priyanshu0915/AC-DC-CONVERTER-FOR-SPEED-CONTROL-OF-A-DC-MOTOR-/README.md

# AC-DC CONVERTER FOR SPEED CONTROL OF A DC MOTOR
<p>This project involves designing and implementing a two-stage AC-DC converter specifically tailored to control the speed of a DC motor. The converter utilizes advanced power electronics to provide efficient and stable speed control, making it suitable for various applications requiring precise motor regulation.</p>
<br>
References 
<br>
1. Anupam Dixit, Bryce Hillam, “A Two Stage AC-DC Converter for Speed Control of a DC 
Motor,” The University of Queensland, Australia.
<br>
2. Texas Instruments, “Loop stability analysis of voltage mode buck regulator,” Application 
Report SLVA301, 2008.
