priyanshu0915/AC-DC-CONVERTER-FOR-SPEED-CONTROL-OF-A-DC-MOTOR-/Output_Voltage.png

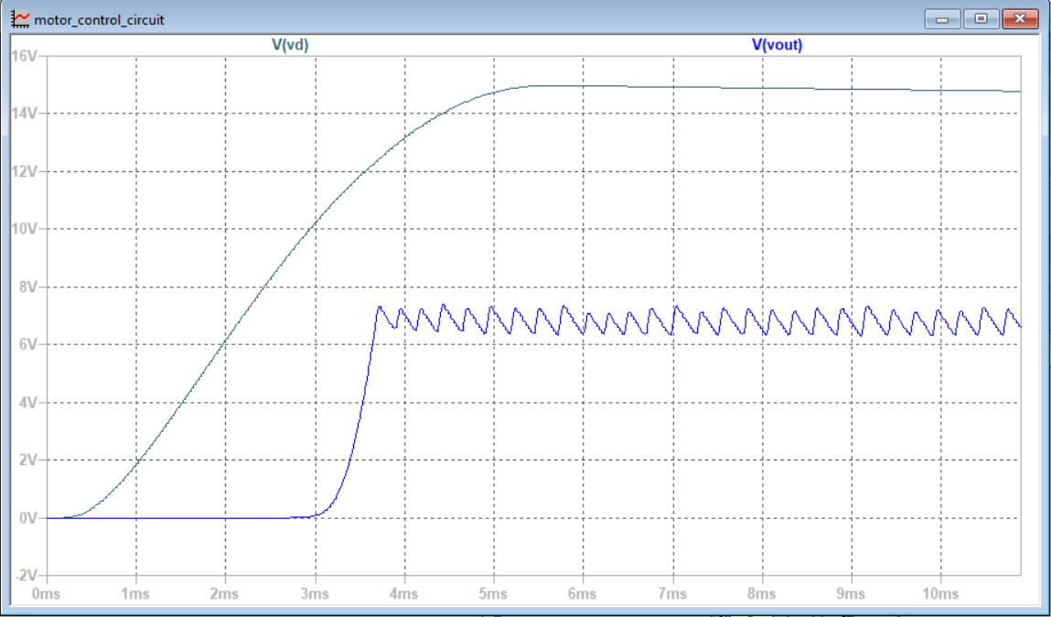
Output_Voltage.png
