priyanshu0915/AC-DC-CONVERTER-FOR-SPEED-CONTROL-OF-A-DC-MOTOR-/PWM.png

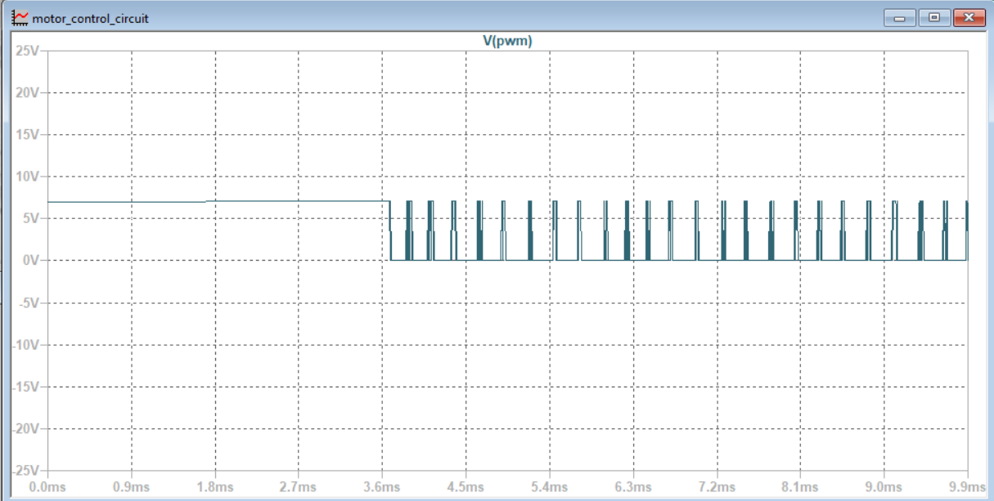
PWM.png
