priyanshu0915/AC-DC-CONVERTER-FOR-SPEED-CONTROL-OF-A-DC-MOTOR-/Circuit_Diagram.asc

C1: cap; 470ľ
C2: cap; 1ľ
C3: cap; 4.7ľ
C4: cap; 10n
C5: cap; 2.2n
C6: cap; 100n
C7: cap; 100n
C8: cap; 100n
C9: cap; 100n
C10: cap; 10ľ
C11: cap; 1ľ; V=50 Irms=3.55 Rser=0.0172 Lser=0 mfg="KEMET" pn="C1210C105K5PAC" type="X5R"
C12: cap; 2.2n
C13: cap; 100n
D1: diode; 1N4148
D2: diode; 1N4148
D3: diode; 1N4148
D4: diode; 1N4148
D6: schottky; 1N5819
D7: diode
D8: diode; 1N4148
L1: ind; 2.2m; Ipk=0.18 Rser=11.8 Rpar=394892 Cpar=0
M1: pmos; IRF9640
Q1: npn; BC547B
Q2: npn; BC547B
Q3: npn; BC547B
Q4: pnp; BC557C
Q5: npn; BC546B
Q6: npn; BC547C
R1: res; 10k
R2: res; 100
R3: res; 10k
R4: res; 1.5k
R5: res; 470
R6: res; 100
R7: res; 10k
R8: res; 100
R9: res; 270k
R10: res; 47k
R11: res; 300
R12: res; 2.2k
R13: res; 20k
R14: res; 10k
R15: res; 100
R16: res; 4.7k
R17: res; 4.7k
R18: res; 4.7K
R19: res; 100k
R20: res; 100k
R21: res; 10k
R22: res; 10k
R23: res; 200k
R24: res; 220k
R25: res; 100k
R26: res; 150k
R27: res; 1.2k
R28: res; 100
U1: NE555
U2: LT1007
U3: LT1007
U4: LT1007
U5: LT1007
U6: NE555
V1: voltage; SINE(0 16.92 50)
V2: voltage; 10
Named nets: 0, Vcc, Vout, Vee, PWM, RAMP, Vd, Vdes
.tran 0 10 100us startup
ramp signal generator
PWM generator
negative charge pump
Driver Circuit
DC to DC Buck Converter
AC to DC converter
