priyanshu0915/AC-DC-CONVERTER-FOR-SPEED-CONTROL-OF-A-DC-MOTOR-/(commit log)

2024-11-12 Add files via upload
    Circuit Diagram
2024-11-12 Circuit Diagram
2024-11-12 Rename Screenshot 2024-11-12 222307.png to PWM.png
